jimwheen/eeg/spice_files/DC_Offset_Transient.asc

C1: cap; 10micro
D1: diode; 1N4148
D2: diode; 1N4148
R1: res; 10k
R2: res; 10k
R3: res; 10k
R4: res; 10k
R5: res; 10k
R6: res; 10k
R7: res; 10k
U1: TL072
V1: voltage; SINE(0 2.8 14)
V6: voltage; 9V
V7: voltage; -9V
V8: voltage; 3.3V
Named nets: 0, Vcc, Vee, 3V3
.tran 0.5
Input Pin
