jimwheen/eeg/spice_files/Main_Circuit_AC.asc

C1: cap; 220n
C2: cap; 220n
C3: cap; 100n
C4: cap; 100n
C5: cap; 10micro
C7: cap; 200n
C8: cap; 100n
C9: cap; 100n
D1: diode; 1N4148
D2: diode; 1N4148
R1: res; 560ohm
R2: res; 100k
R3: res; 22k
R4: res; 22k
R5: res; 47k
R6: res; 100k
R7: res; 47k
R8: res; 10k
R9: res; 10k
R10: res; 10k
R11: res; 10k
R12: res; 10k
R13: res; 27k
R14: res; 27k
R15: res; 13.5k
R16: res; 10k
R17: res; 560ohm
R18: res; 10k
R19: res; 10k
R20: res; 10k
R21: res; 10k
U1: AD620
U2: TL072
U3: TL072
U4: TL072
U5: TL072
U6: TL072
U7: AD620
V1: voltage; AC 1
V2: voltage; 9V
V3: voltage; -9V
V4: voltage; 3.3V
Named nets: 0, Vcc, Vee, 3V3
.include AD620.cir
.ac dec 100 0.1 200
Input Pin (A0)
